marecl/Kubkuino/RawDoc/InstrukcjaUrzadzenie/IMG_20180307_215736.jpg

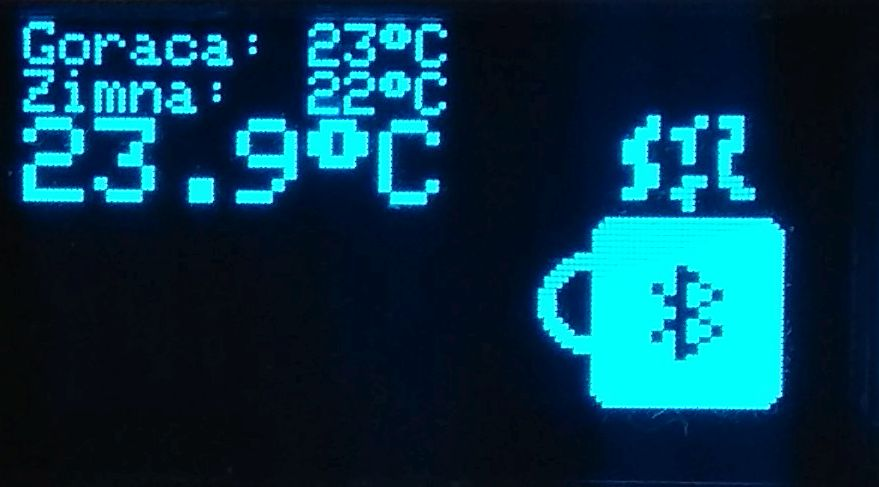
RawDoc/InstrukcjaUrzadzenie/IMG_20180307_215736.jpg
