marecl/Kubkuino/RawDoc/InstrukcjaUrzadzenie/IMG_20180307_215650.jpg

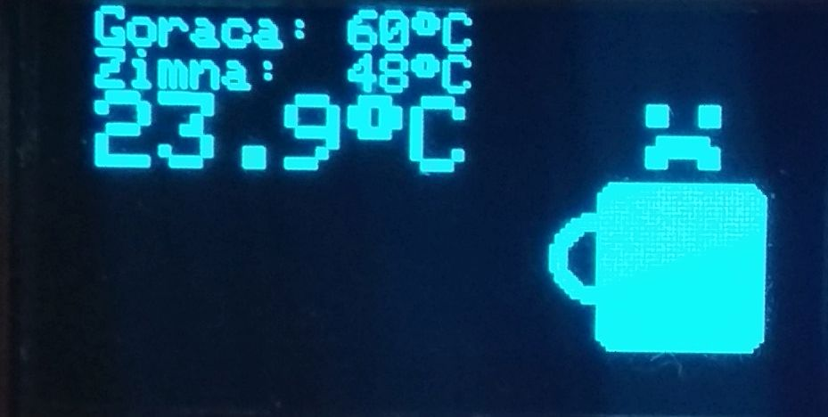
RawDoc/InstrukcjaUrzadzenie/IMG_20180307_215650.jpg
