marecl/Kubkuino/Kubkuino/README.md

Parts:
* SSD1306 128x64 OLED display
* 3 LEDs - red, green and blue
* MLX90614 IR temperature sensor

Designed in KiCAD.  
Board has two layers, but the bottom one is only for ICSP header.  
All goldpin headers/sockets are SMD.

Drawings made in DraftSight. Unfortunately - you have to measure everything on your own.
