marecl/Kubkuino/Kubkuino/README_PL.md

Użycte części:
* Wyświetlacz OLED SSD1306 128x64  
* 3 LEDy - czerwona, zielona, niebieska
* podczerwony czujnik temperatury MLX90614  

Zaprojektowane w KiCAD.  
Płytka ma dwie warstwy, z czego dolna jest tylko doprowadzeniem do złącza programatora i masy.  

Rysunki zrobione w DraftSight 2017, wymiarów niestety brak.
