marecl/Kubkuino/Kubkuino/Case_IR/Concept.png

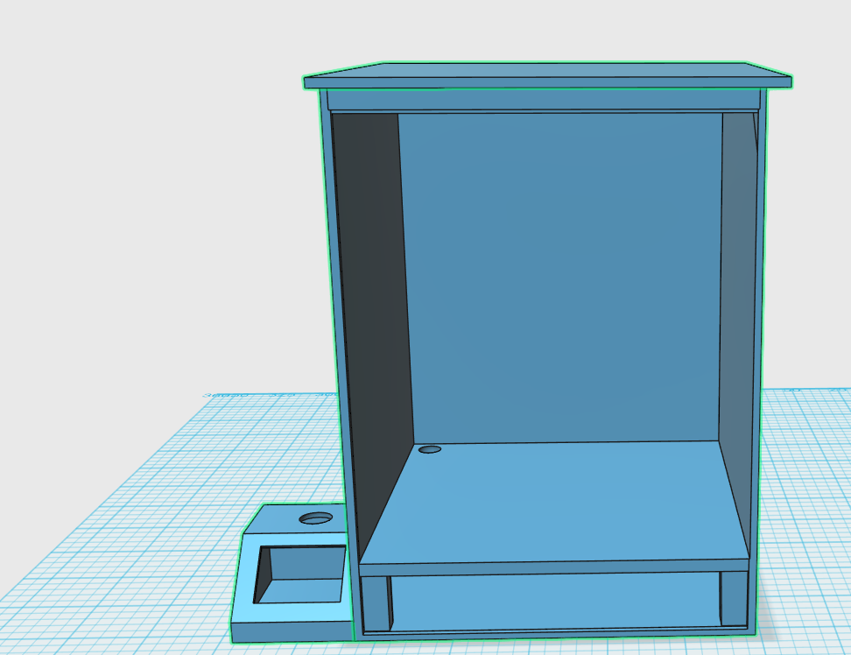
Kubkuino/Case_IR/Concept.png
