marecl/Kubkuino/Kubkuino/Case_IR/Final.jpg

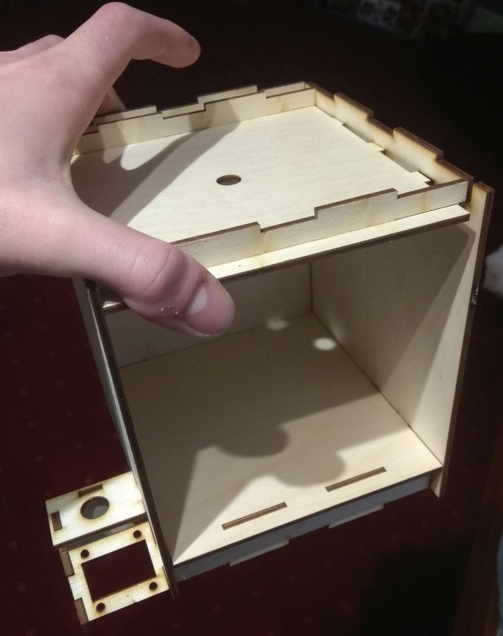
Kubkuino/Case_IR/Final.jpg
