marecl/Kubkuino/RawDoc/InstrukcjaUrzadzenie/IMG_20180307_215737.jpg

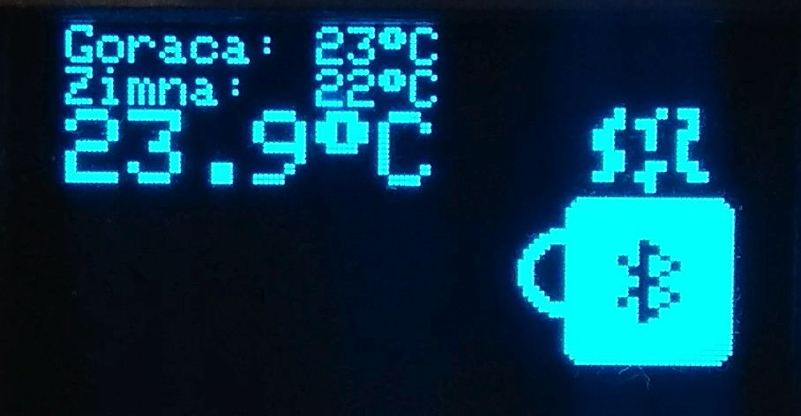
RawDoc/InstrukcjaUrzadzenie/IMG_20180307_215737.jpg
