marecl/Kubkuino/(list of files, cad)

Other CAD files:
Kubkuino/Case_IR/Case.dwg
