marecl/Kubkuino/Kubkuino/Kubkuino_Board/Kubkuino_Board.kicad_pcb

## KiCad design Kubkuino/Kubkuino_Board/Kubkuino_Board.kicad_pcb (2019-05-23)

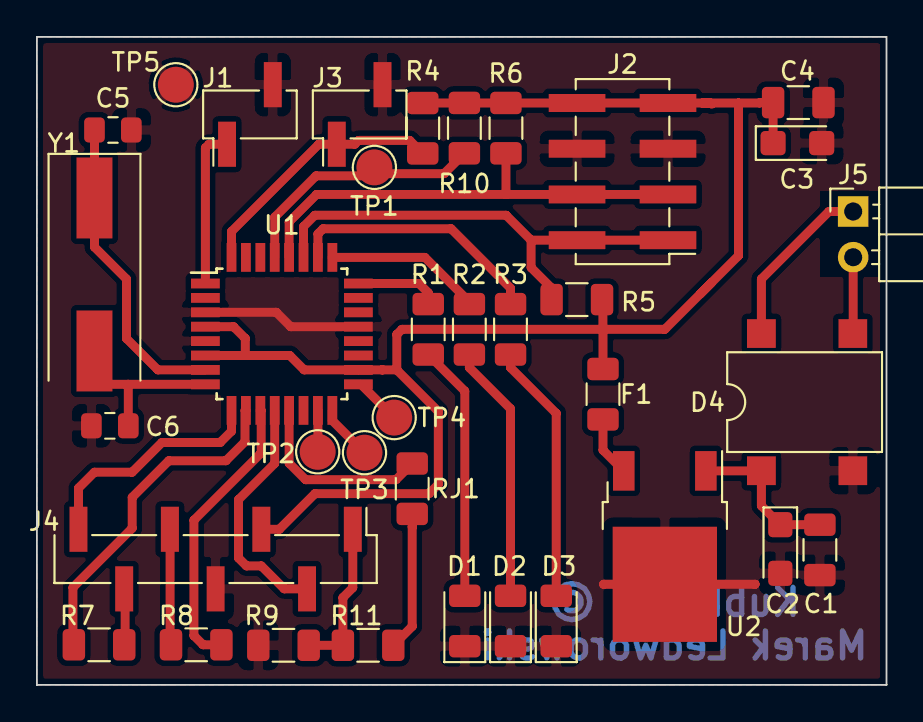
[picture p35: board Kubkuino_Board.kicad_pcb from above]

Board: 2 copper layers, 47.2 x 36.0 mm, 36 parts (0 on the bottom side), 31 nets.

Parts:
C1, C4: 100nF; C_1206_3216Metric
C2, C3: 1uF; CP_EIA-3216-18_Kemet-A
C5, C6: 22pF; C_0805_2012Metric_Pad1.15x1.40mm_HandSolder
D1: LED_R; LED_1206_3216Metric
D2: LED_G; LED_1206_3216Metric
D3: LED_B; LED_1206_3216Metric
D4: DF08M; Diode_Bridge_DIP-4_W7.62mm_P5.08mm
F1: 500mA 6V; R_1206_3216Metric
J1: Piezo; PinHeader_1x02_P2.54mm_Vertical_SMD_Pin1Left
J2: I2C; PinHeader_2x04_P2.54mm_Vertical_SMD
J3: Button; PinHeader_1x02_P2.54mm_Vertical_SMD_Pin1Left
J4: Bluetooth; PinHeader_1x07_P2.54mm_Vertical_SMD_Pin1Left
J5: AC/DC In (12V); PinHeader_1x02_P2.54mm_Horizontal
R1, R2, R3: 220; R_1206_3216Metric
R4: 1k; R_1206_3216Metric
R5, R6, R7, R8, R11: 4k7; R_1206_3216Metric
R9, R10: 10k; R_1206_3216Metric
RJ1: 0; R_1206_3216Metric
TP1: RESET; TestPoint_Pad_D2.0mm
TP2: MOSI; TestPoint_Pad_D2.0mm
TP3: MISO; TestPoint_Pad_D2.0mm
TP4: SCK; TestPoint_Pad_D2.0mm
TP5: GND; TestPoint_Pad_D2.0mm
U1: ATmega328P-AU; TQFP-32_7x7mm_P0.8mm
U2: LM7805_TO220; TO-252-2
Y1: Crystal; Crystal_SMD_HC49-SD

Connections:
5V: C3.1, C4.1, F1.1, J2.7, J2.8, J4.3, R4.1, R5.2, R6.2, R10.1, U1.4, U1.6, U1.18
/MISO: TP3.1, U1.16
/MOSI: TP2.1, U1.15
/SCK: TP4.1, U1.17
BTen: J4.2, U1.12
BTkey: RJ1.1, U1.13
Brx: R7.2, U1.10
BtConn: J4.7, U1.9
Btx: R8.2, U1.11
Button: J3.1, R4.2, U1.32
GND: C1.2, C2.2, C3.2, C4.2, C5.2, C6.2, D1.1, D2.1, D3.1, D4.2, J1.2, J2.5, J2.6, J3.2, J4.4, R9.1, TP5.1, U1.3, U1.5, U1.21, U2.2
unnamed: C1.1, C2.1, D4.1, U2.1
unnamed: D1.2, R1.1
unnamed: D2.2, R2.1
unnamed: D3.2, R3.1
unnamed: D4.3, J5.2
unnamed: D4.4, J5.1
unnamed: F1.2, U2.3
unnamed: J1.1, U1.1
unnamed: J4.1, R9.2, R11.2
unnamed: J4.5, R8.1
unnamed: J4.6, R7.1
unnamed: R1.2, U1.24
unnamed: R2.2, U1.25
unnamed: R3.2, U1.26
unnamed: R11.1, RJ1.2
Reset: R10.2, TP1.1, U1.29
SCL: J2.3, J2.4, R6.1, U1.28
SDA: J2.1, J2.2, R5.1, U1.27
xtal1: C5.1, U1.7, Y1.1
xtal2: C6.1, U1.8, Y1.2
