marecl/Kubkuino/(commit log)

2017-04-03 Ostatnie szlify
    [Aluminium_Plaskie.csv, Szklanka_Wklesle.csv, WykresyWSZYSTKO.xlsx]
2017-04-05 Moze juz koniec
    [KubkuinoDNO.fzz]
2017-06-26 Started working on Serial version
    TODO:
    Update everything from main version
    Prepare board in KiCAD instead of Fritzing
    Get IR contactless temperature sensor and begin working with it
    I've probably screwed up PC application, so... yeah. VC++Express is not
    so well copmpatible with 2017...
    [KubkuinoDNO_Serial.fzz]
2017-07-23 Updates
    Updated to VS2017 (Community)
    Optimized main sketch (no compiler warnings)
    Made new full-smd board in KiCAD
    [Board.kicad_pcb, Board.sch, KubkuinoDNO.fzz, KubkuinoDNO_Serial.fzz]
2017-07-27 Upgrades
    Aktualizacja głównego kodu do użycia czujnika podczerwonego
    Ukończenie płytki (SMD)
    [Board.kicad_pcb, Board.sch]
2017-09-08 Fixed SMD board
    [Board.kicad_pcb, Board.sch]
2017-09-20 Finished PCB
    [Board — kopia.kicad_pcb, Board.csv, Board.kicad_pcb, _saved_Board.sch]
2017-10-12 Minor optimization
    Board GY906:
    Removed ICSP header and replaced with pads
    Moved power input to the edge
    Added fuse after LM7805
    GY906 sketch:
    Alarm has got new launch method (removed booleans)
    Removed unused headers
    Selected one tone frequency for buzzer
    Some other things
    [Board — kopia.kicad_pcb, Board.csv, Board.kicad_pcb, Board.sch, _saved_Board.sch]
2018-03-09 Large update
    Removed old hardware version
    Custom case to laser-print (plexi, plywood 3mm)
    Infrared sensor
    Bluetooth connectivity
    Local settings saving
    Better PC application
    Updated documentation
    [Aliminium_Wklesle.csv, Aluminium_Plaskie.csv, BackupDanych.xlsx, Board.kicad_pcb, Board.sch, Case.dwg, Ceramika_Plaskie.csv, Ceramika_Wklesle.csv]
2019-04-30 Large update
    Code:
    Changed name of file
    Added translations (PL/ENG)
    Removed unneeded libraries
    Board:
    Upgraded schematic with KiCAD 5.1.2
    Removed unnecessary rescue files
    Silkscreen elements properly aligned
    Changed name of files
    Added photo of the final case
    Tracks cleanup and slight re-routing
    [Board.kicad_pcb, Kubkuino_Board.kicad_pcb, Kubkuino_Board.sch]
2019-05-23 Board optimization
    Smaller board (couple of millimeters shorter)
    Removed ICSP header
    Added pads for programming
    Changed rectifying section: DF08S (in schematic: DF08M, for THT change pads to through-hole)
    Added missing resistor on reset line
    No connections from before the fuse
    [Kubkuino_Board.kicad_pcb, Kubkuino_Board.sch]
